AlessandroSpagnuolo/Prog2/secondo progetto/Ice_Hockey_Robot/Documenti_Esterni/Evo_Parts/images/c48fbc577b86a8ed6186f991ce8d50e0_preview_featured.jpg

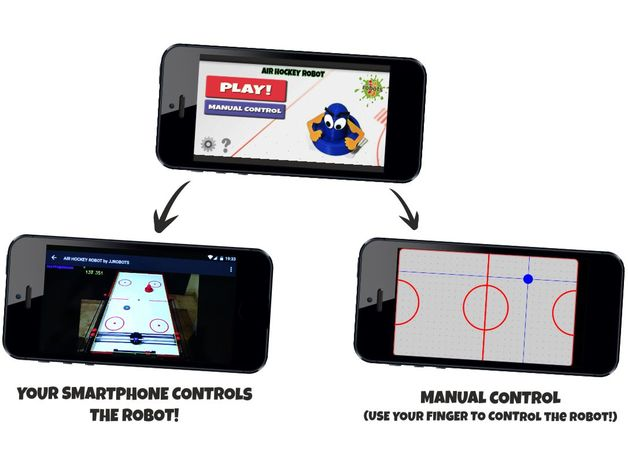
secondo progetto/Ice_Hockey_Robot/Documenti_Esterni/Evo_Parts/images/c48fbc577b86a8ed6186f991ce8d50e0_preview_featured.jpg
