AlessandroSpagnuolo/Prog2/secondo progetto/Ice_Hockey_Robot/Documenti_Esterni/Evo_Parts/images/e0535dc348d9a77c046b0b79b14cc791_preview_featured.jpg

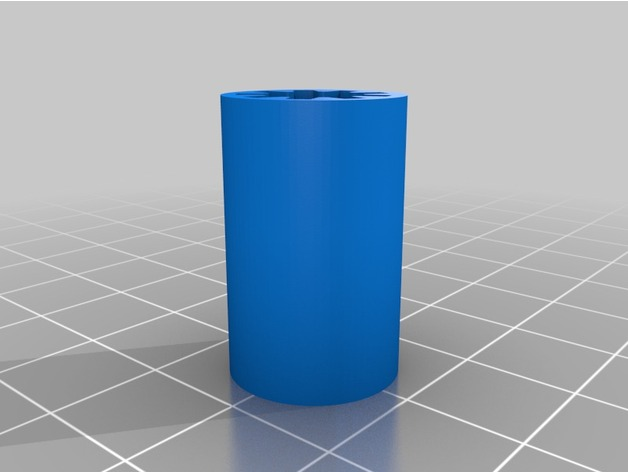
secondo progetto/Ice_Hockey_Robot/Documenti_Esterni/Evo_Parts/images/e0535dc348d9a77c046b0b79b14cc791_preview_featured.jpg
