AlessandroSpagnuolo/Prog2/README.md

# Prog2
secondo progetto: air ice hockey
