AlessandroSpagnuolo/Prog2/secondo progetto/Ice_Hockey_Robot/Documenti_Esterni/Evo_Parts/images/4bc8e7be909e8ec01cc87e8b50d460f5_preview_featured.jpg

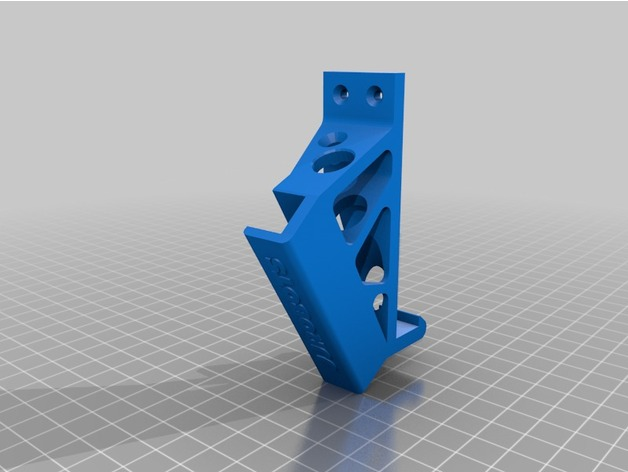
secondo progetto/Ice_Hockey_Robot/Documenti_Esterni/Evo_Parts/images/4bc8e7be909e8ec01cc87e8b50d460f5_preview_featured.jpg
