AlessandroSpagnuolo/Prog2/secondo progetto/Ice_Hockey_Robot/Documenti_Esterni/Evo_Parts/images/6b97cc918e33d01fea8eba4c3b66e9ec_preview_featured.JPG

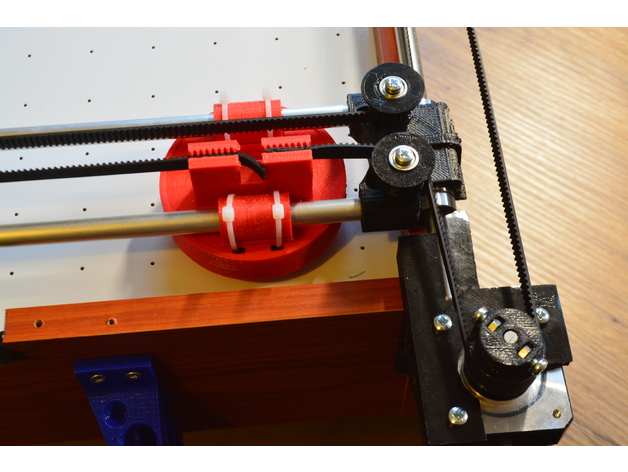
secondo progetto/Ice_Hockey_Robot/Documenti_Esterni/Evo_Parts/images/6b97cc918e33d01fea8eba4c3b66e9ec_preview_featured.JPG
