AlessandroSpagnuolo/Prog2/secondo progetto/Ice_Hockey_Robot/Documenti_Esterni/Evo_Parts/images/6fe7fa6bc25f6dac1cbf8202e3f6bd43_preview_featured.jpg

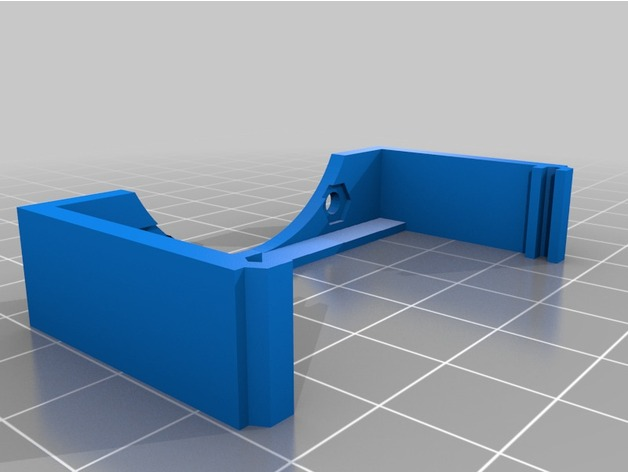
secondo progetto/Ice_Hockey_Robot/Documenti_Esterni/Evo_Parts/images/6fe7fa6bc25f6dac1cbf8202e3f6bd43_preview_featured.jpg
