AlessandroSpagnuolo/Prog2/secondo progetto/Ice_Hockey_Robot/Documenti_Esterni/Evo_Parts/images/8eeb0d9ac41b5c2f0e98d45f4a3cb0bf_preview_featured.jpg

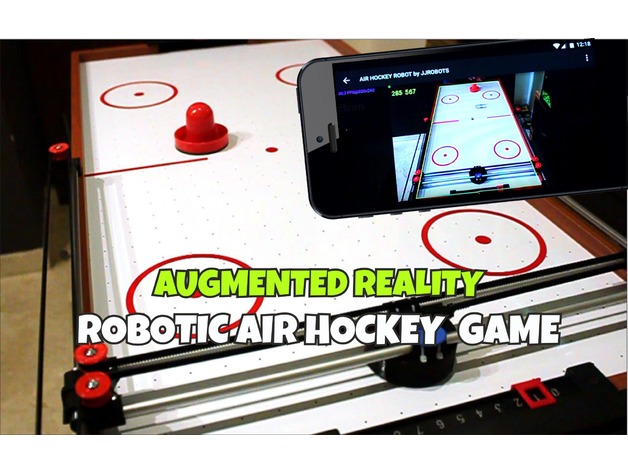
secondo progetto/Ice_Hockey_Robot/Documenti_Esterni/Evo_Parts/images/8eeb0d9ac41b5c2f0e98d45f4a3cb0bf_preview_featured.jpg
