AlessandroSpagnuolo/Prog2/secondo progetto/Ice_Hockey_Robot/Documenti_Esterni/Evo_Parts/images/14b6061b0e490b5b1b85e35cb138148e_preview_featured.jpg

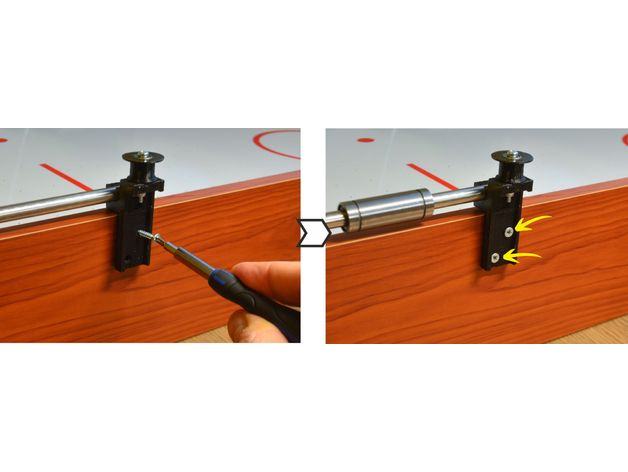
secondo progetto/Ice_Hockey_Robot/Documenti_Esterni/Evo_Parts/images/14b6061b0e490b5b1b85e35cb138148e_preview_featured.jpg
