AlessandroSpagnuolo/Prog2/secondo progetto/Ice_Hockey_Robot/Documenti_Esterni/Evo_Parts/images/46a5b4af4dbc3434ce3a769a0f5a52c9_preview_featured.jpg

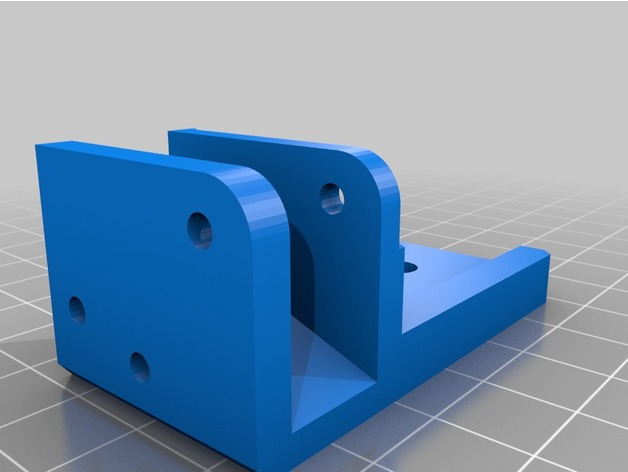
secondo progetto/Ice_Hockey_Robot/Documenti_Esterni/Evo_Parts/images/46a5b4af4dbc3434ce3a769a0f5a52c9_preview_featured.jpg
