AlessandroSpagnuolo/Prog2/secondo progetto/Ice_Hockey_Robot/Documenti_Esterni/Evo_Parts/images/62b32cb062a58d0043e46ae764baa3e8_preview_featured.jpg

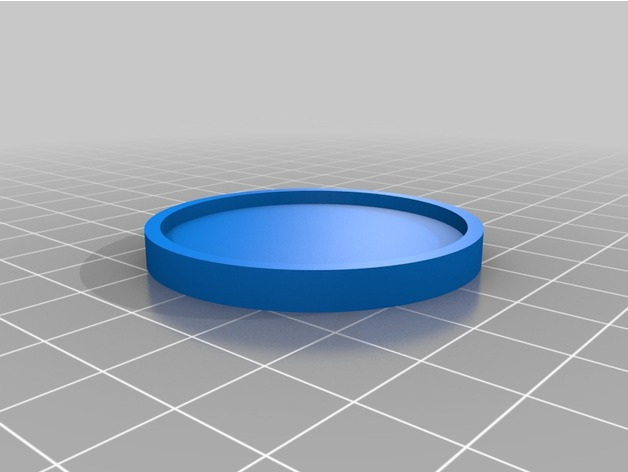
secondo progetto/Ice_Hockey_Robot/Documenti_Esterni/Evo_Parts/images/62b32cb062a58d0043e46ae764baa3e8_preview_featured.jpg
