AlessandroSpagnuolo/Prog2/secondo progetto/Ice_Hockey_Robot/Documenti_Esterni/Evo_Parts/images/70a5b05cea57b153b153dd28bbcd6b00_preview_featured.jpg

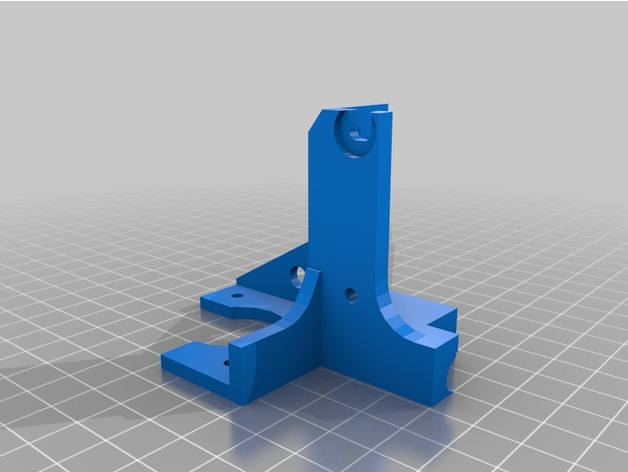
secondo progetto/Ice_Hockey_Robot/Documenti_Esterni/Evo_Parts/images/70a5b05cea57b153b153dd28bbcd6b00_preview_featured.jpg
