AlessandroSpagnuolo/Prog2/secondo progetto/Ice_Hockey_Robot/Documenti_Esterni/Evo_Parts/images/471bc7bbe3de74142f9f68eadd3e1e48_preview_featured.jpg

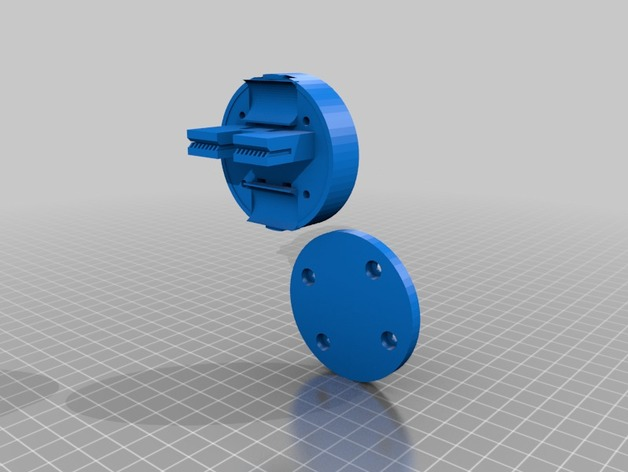
secondo progetto/Ice_Hockey_Robot/Documenti_Esterni/Evo_Parts/images/471bc7bbe3de74142f9f68eadd3e1e48_preview_featured.jpg
