AlessandroSpagnuolo/Prog2/secondo progetto/Ice_Hockey_Robot/Documenti_Esterni/Evo_Parts/images/a5cfed5209e7e8db20794ae717948012_preview_featured.jpg

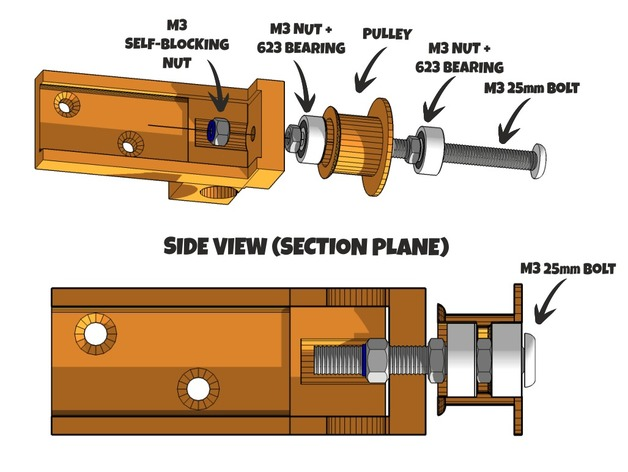
secondo progetto/Ice_Hockey_Robot/Documenti_Esterni/Evo_Parts/images/a5cfed5209e7e8db20794ae717948012_preview_featured.jpg
