AlessandroSpagnuolo/Prog2/secondo progetto/Ice_Hockey_Robot/Documenti_Esterni/Evo_Parts/images/b7c1290165616fea5d7978f63457bd04_preview_featured.jpg

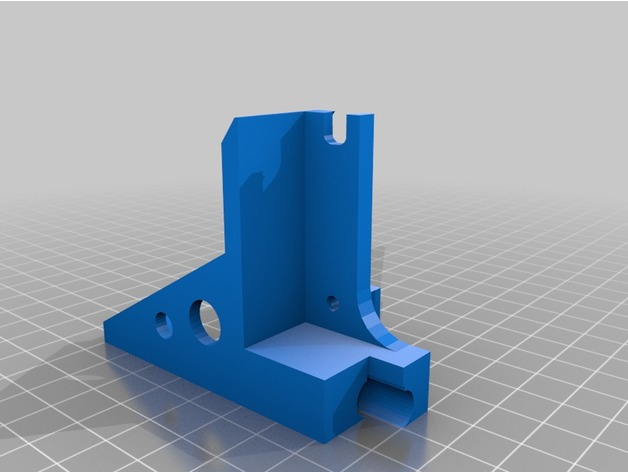
secondo progetto/Ice_Hockey_Robot/Documenti_Esterni/Evo_Parts/images/b7c1290165616fea5d7978f63457bd04_preview_featured.jpg
