AlessandroSpagnuolo/Prog2/secondo progetto/Ice_Hockey_Robot/Documenti_Esterni/Evo_Parts/images/b9a10730b806a6207119c4c1957f6d4a_preview_featured.jpg

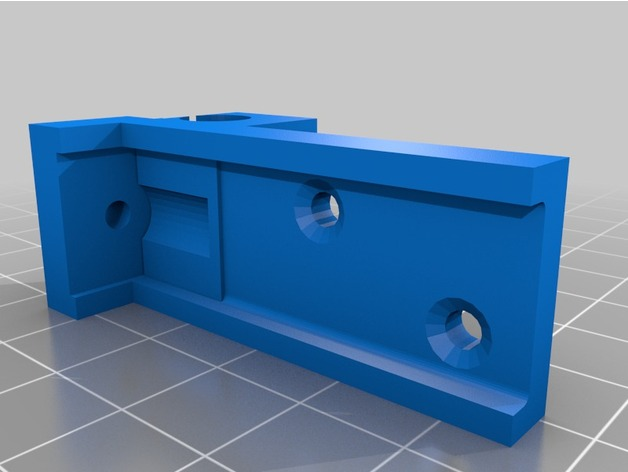
secondo progetto/Ice_Hockey_Robot/Documenti_Esterni/Evo_Parts/images/b9a10730b806a6207119c4c1957f6d4a_preview_featured.jpg
