AlessandroSpagnuolo/Prog2/secondo progetto/Ice_Hockey_Robot/Documenti_Esterni/Evo_Parts/images/e60eaf93e7c9d5d394abe98cd1afeca5_preview_featured.jpg

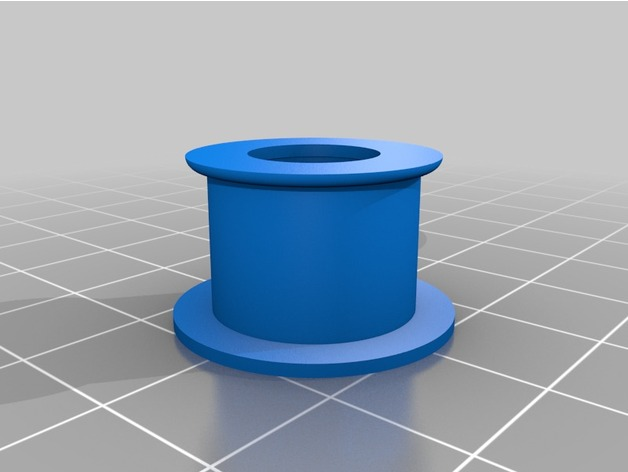
secondo progetto/Ice_Hockey_Robot/Documenti_Esterni/Evo_Parts/images/e60eaf93e7c9d5d394abe98cd1afeca5_preview_featured.jpg
