AlessandroSpagnuolo/Prog2/secondo progetto/Ice_Hockey_Robot/Documenti_Esterni/Evo_Parts/images/fa7780b0aadf123c87ee873376358e9c_preview_featured.jpg

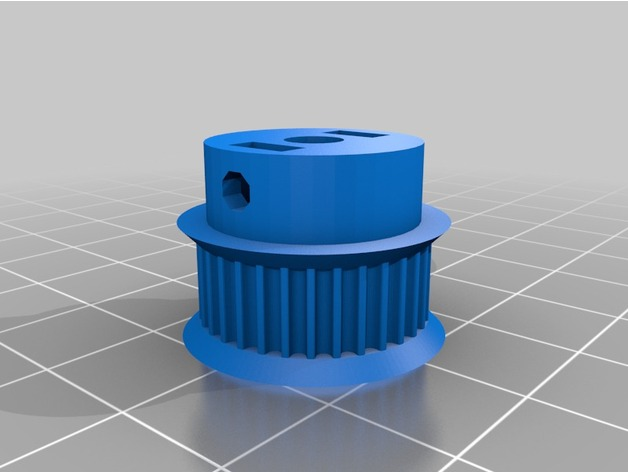
secondo progetto/Ice_Hockey_Robot/Documenti_Esterni/Evo_Parts/images/fa7780b0aadf123c87ee873376358e9c_preview_featured.jpg
