AlessandroSpagnuolo/Prog2/secondo progetto/Ice_Hockey_Robot/Documenti_Esterni/Evo_Parts/files/PUCK.stl

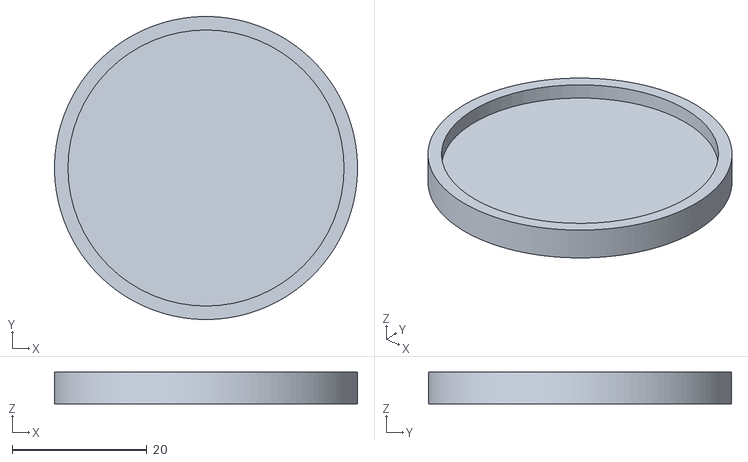
[picture p18: CAD file, 2017-11-10]
secondo progetto/Ice_Hockey_Robot/Documenti_Esterni/Evo_Parts/files/PUCK.stl
45.0 x 45.0 x 4.75
