AlessandroSpagnuolo/Prog2/secondo progetto/Ice_Hockey_Robot/Documenti_Esterni/Evo_Parts/files/pusher_2parts.stl

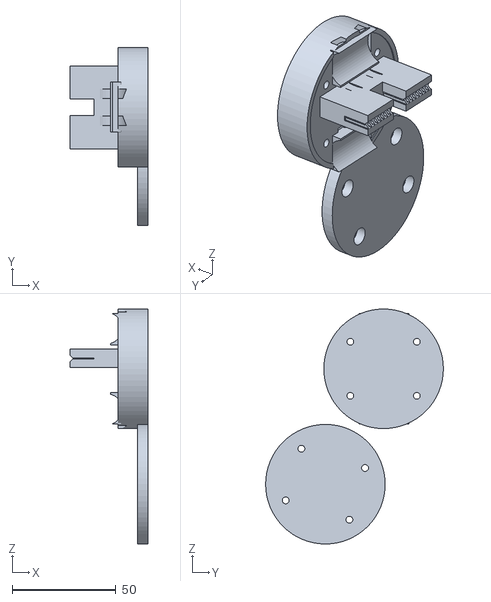
[picture p19: CAD file, 2017-11-10]
secondo progetto/Ice_Hockey_Robot/Documenti_Esterni/Evo_Parts/files/pusher_2parts.stl
37.5 x 85.5 x 113.0
