AlessandroSpagnuolo/Prog2/secondo progetto/Ice_Hockey_Robot/Documenti_Esterni/Evo_Parts/files/MOTOR_PULLEY.stl

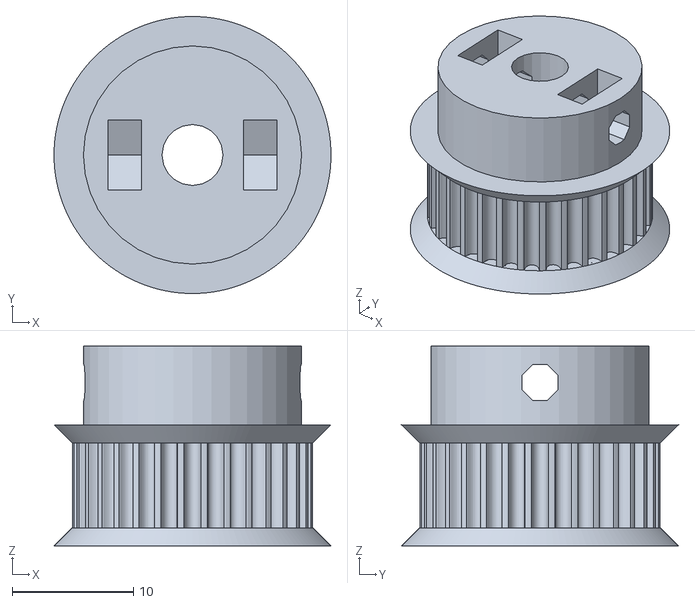
[picture p20: CAD file, 2017-11-10]
secondo progetto/Ice_Hockey_Robot/Documenti_Esterni/Evo_Parts/files/MOTOR_PULLEY.stl
22.9 x 22.9 x 16.5
