AlessandroSpagnuolo/Prog2/secondo progetto/Ice_Hockey_Robot/Documenti_Esterni/Evo_Parts/files/BUSHING.stl

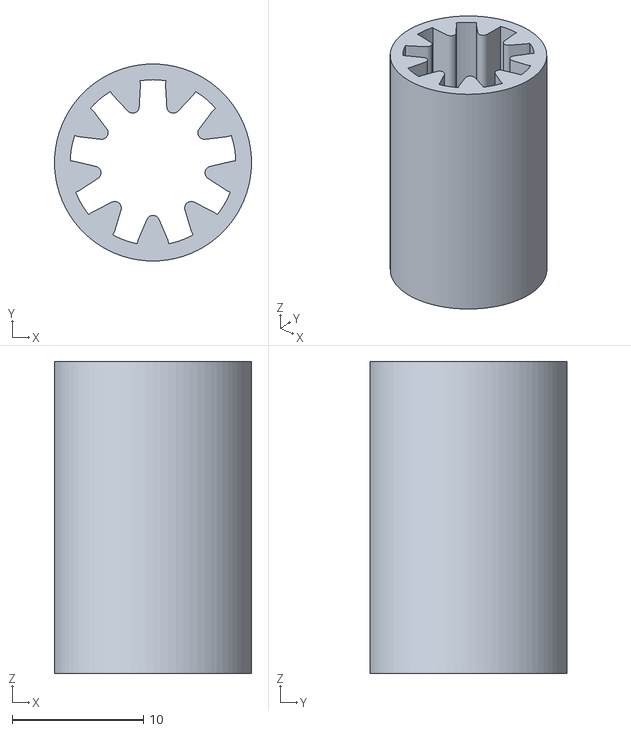
[picture p21: CAD file, 2017-11-10]
secondo progetto/Ice_Hockey_Robot/Documenti_Esterni/Evo_Parts/files/BUSHING.stl
15.0 x 15.0 x 23.8
