AlessandroSpagnuolo/Prog2/secondo progetto/Ice_Hockey_Robot/Documenti_Esterni/Evo_Parts/files/LATERAL_SUPPORT.stl

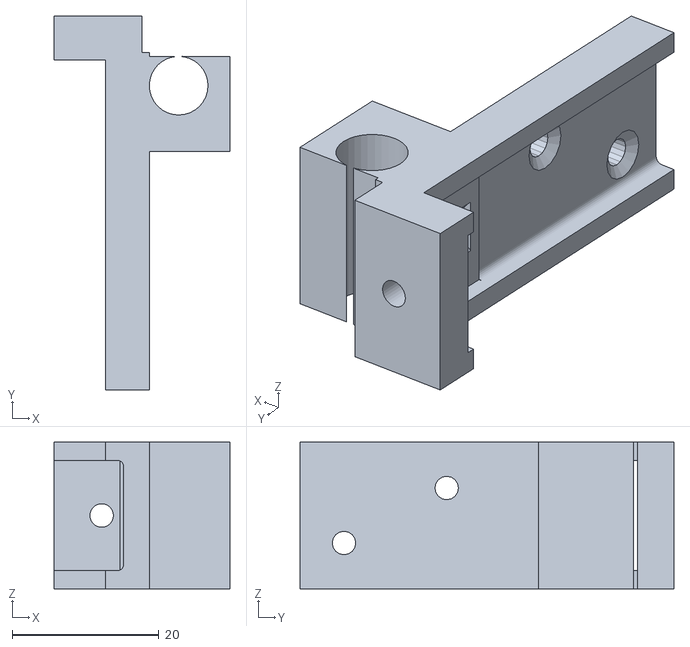
[picture p22: CAD file, 2017-11-10]
secondo progetto/Ice_Hockey_Robot/Documenti_Esterni/Evo_Parts/files/LATERAL_SUPPORT.stl
24.0 x 51.0 x 20.0
