AlessandroSpagnuolo/Prog2/secondo progetto/Ice_Hockey_Robot/Documenti_Esterni/Evo_Parts/files/POLE_SUPPORT_BASE.stl

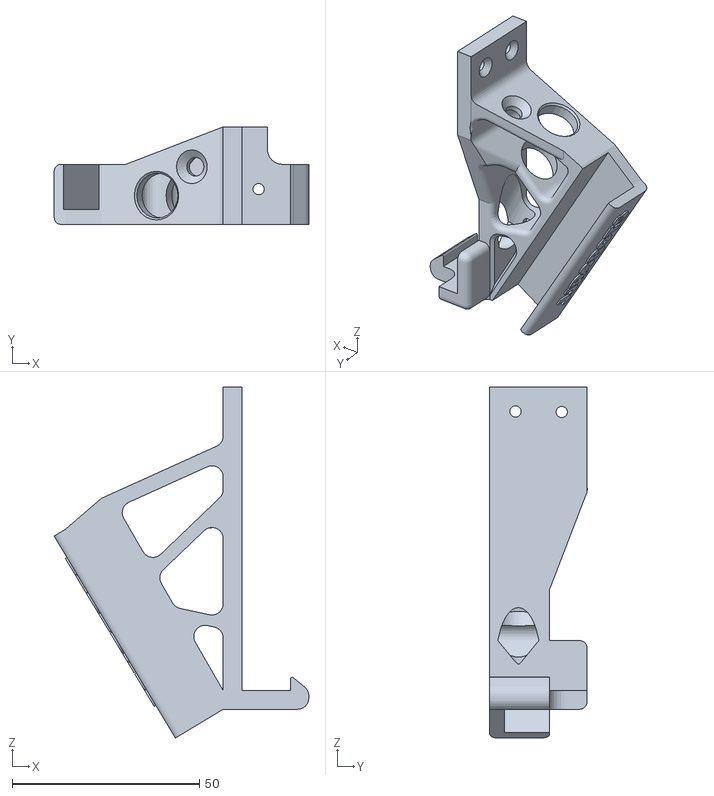
[picture p23: CAD file, 2017-11-10]
secondo progetto/Ice_Hockey_Robot/Documenti_Esterni/Evo_Parts/files/POLE_SUPPORT_BASE.stl
68.0 x 26.0 x 93.7
