AlessandroSpagnuolo/Prog2/secondo progetto/Ice_Hockey_Robot/Documenti_Esterni/Evo_Parts/files/FAN_SUPPORT.stl

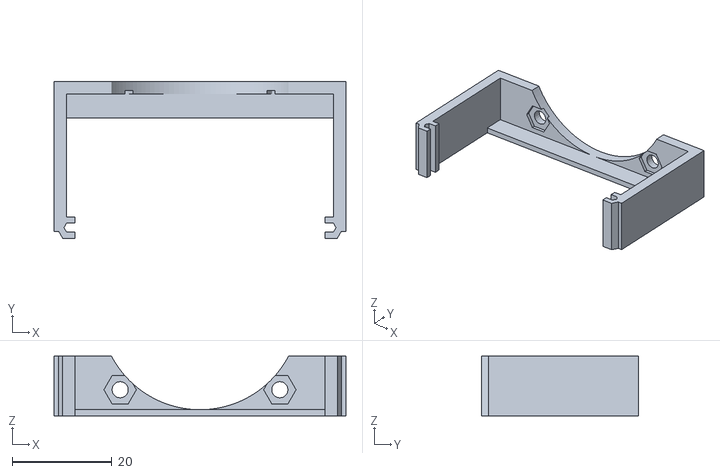
[picture p24: CAD file, 2017-11-10]
secondo progetto/Ice_Hockey_Robot/Documenti_Esterni/Evo_Parts/files/FAN_SUPPORT.stl
58.5 x 31.4 x 12.0
