AlessandroSpagnuolo/Prog2/secondo progetto/Ice_Hockey_Robot/Documenti_Esterni/Evo_Parts/files/Ice_Puck.3mf

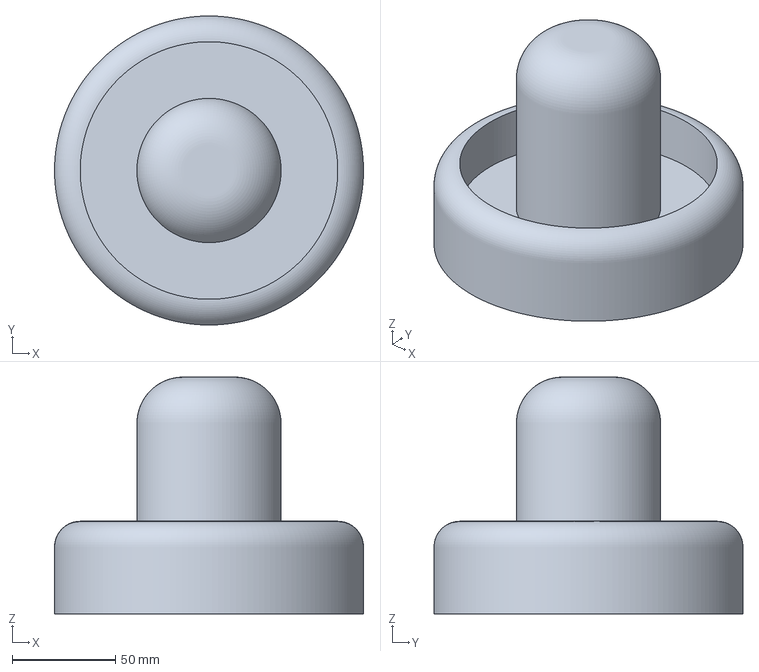
[picture p25: CAD file, 2017-11-10]
secondo progetto/Ice_Hockey_Robot/Documenti_Esterni/Evo_Parts/files/Ice_Puck.3mf
150.0 x 150.0 x 115.0 mm
