AlessandroSpagnuolo/Prog2/secondo progetto/Ice_Hockey_Robot/Documenti_Esterni/Evo_Parts/files/MOTOR_HOLDER_LEFT.stl

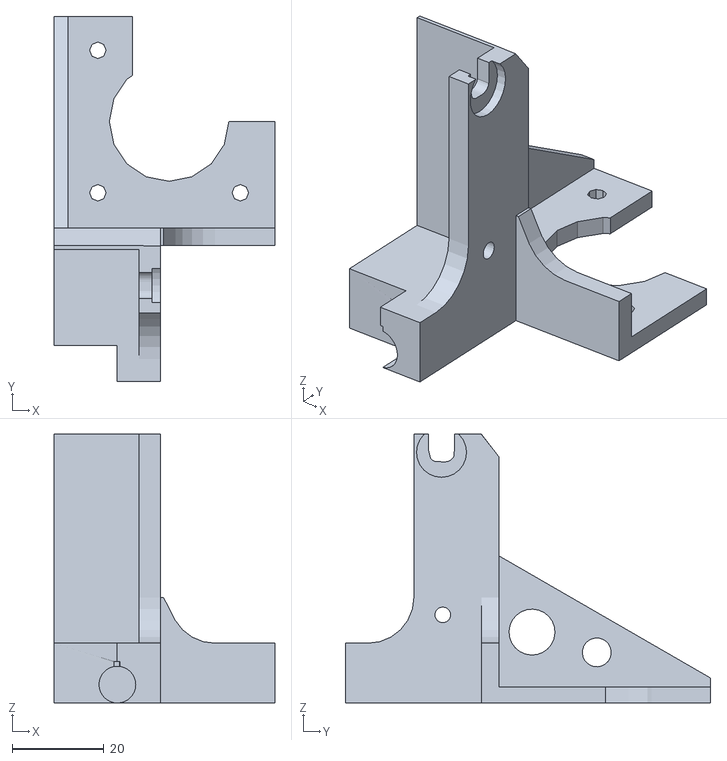
[picture p27: CAD file, 2017-11-10]
secondo progetto/Ice_Hockey_Robot/Documenti_Esterni/Evo_Parts/files/MOTOR_HOLDER_LEFT.stl
48.0 x 79.5 x 58.5
