AlessandroSpagnuolo/Prog2/secondo progetto/Ice_Hockey_Robot/Documenti_Esterni/Evo_Parts/files/SMARTPHONE_SUPPORT_TOP.stl

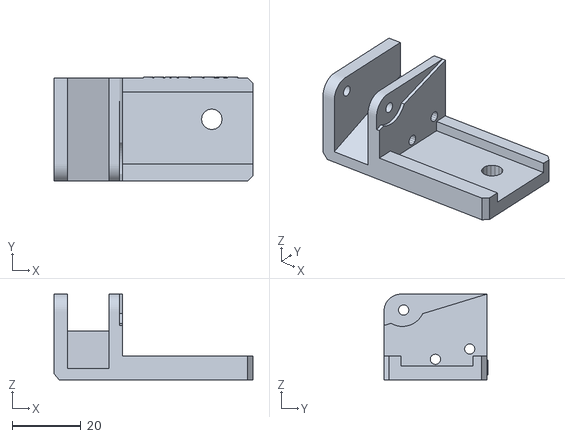
[picture p28: CAD file, 2017-11-10]
secondo progetto/Ice_Hockey_Robot/Documenti_Esterni/Evo_Parts/files/SMARTPHONE_SUPPORT_TOP.stl
58.0 x 30.3 x 25.0
