AlessandroSpagnuolo/Prog2/secondo progetto/Ice_Hockey_Robot/Documenti_Esterni/Evo_Parts/files/LATERAL_SLIDER.stl

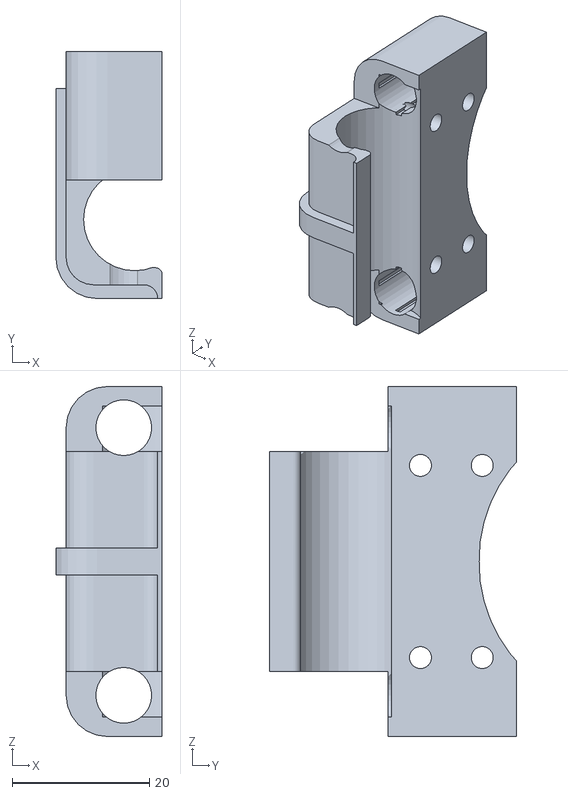
[picture p29: CAD file, 2017-11-10]
secondo progetto/Ice_Hockey_Robot/Documenti_Esterni/Evo_Parts/files/LATERAL_SLIDER.stl
15.5 x 36.0 x 51.0
