AlessandroSpagnuolo/Prog2/(list of files, cad)

Other CAD files:
secondo progetto/Ice_Hockey_Robot/Documenti_Esterni/Evo_Parts/files/MOTOR_HOLDER_RIGHT.stl
secondo progetto/Ice_Hockey_Robot/Documenti_Esterni/Evo_Parts/files/Ice_Puck.stl
