AlessandroSpagnuolo/Prog2/secondo progetto/diari/I3_DIARIO_PROG2_2017_11_10.docx

# Diario di lavoro

Luogo | Trevano
Data | 10.11.17

Lavori svolti

Oggi ho guardato i vari file pdf e i vari video che ci sono stati dati per informarmi sul progetto assegnatoci. Ho anche iniziato e completato il diagramma di gantt preventivo con tutte le attività che io e il mio gruppo andremo a fare.

Problemi riscontrati e soluzioni adottate

Nessun problema riscontrato.

Punto della situazione rispetto alla pianificazione

Essendo la prima lezione del progetto e visto che la pianificazione tramite il diagramma di gantt l’ho fatta oggi non posso dire di essere indietro rispetto alla pianificazione.

Programma di massima per la prossima giornata di lavoro

- Stampare in 3D i pezzi per il progetto
- Cominciare a informarmi su come raccogliere i dati che trasmette l’applicazione JJRobots all’arduino

Nome Progetto: 1/1

Alessandro Spagnuolo I3BB
